mikepurvis/kenwood/audio_pipeline.sch

## KiCad design audio_pipeline.sch (2012-08-21)

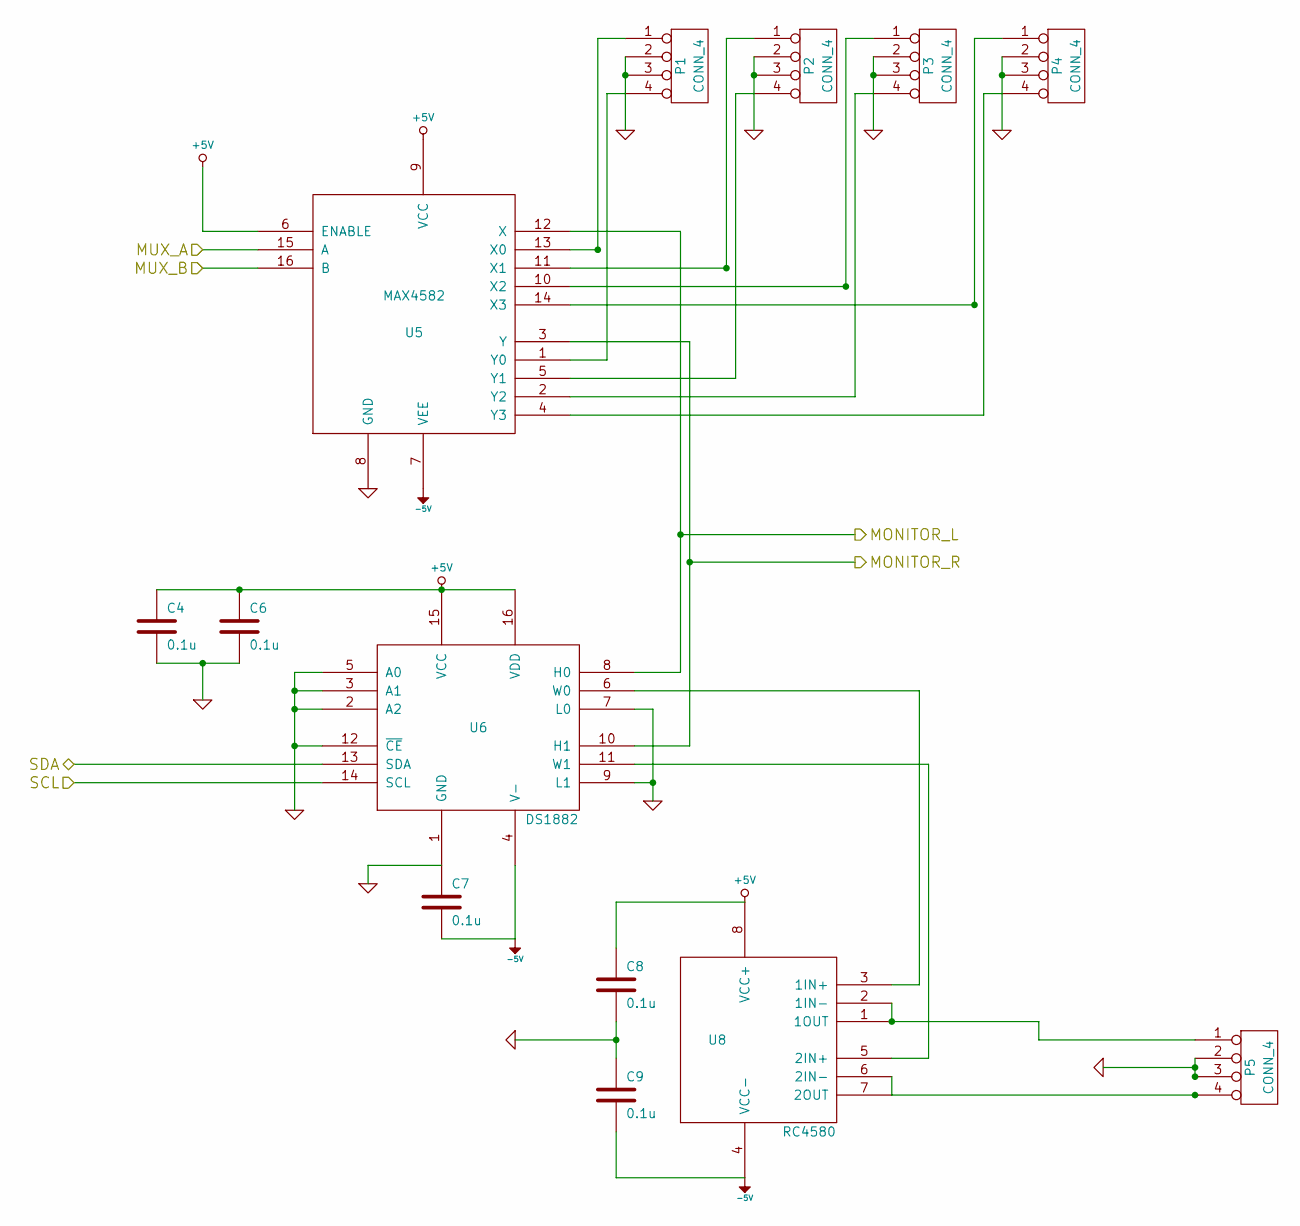
[picture p1: schematic audio_pipeline.sch]

Parts:
C4, C6, C7, C8, C9: 0.1u; Digikey 445-5122-1-ND
P1, P2, P3, P4, P5: CONN_4; Digikey WM4926-ND
U5: MAX4582; MODULE; Digikey MAX4582CSE+-ND
U6: DS1882; SOIC16; Digikey DS1882Z-050+-ND
U8: RC4580; MODULE; Digikey 296-15367-1-ND

Connections:
+5V: C4.1, C6.1, C8.1, U5.6 (ENABLE), U5.9 (VCC), U6.15 (VCC), U6.16 (VDD), U8.8 (VCC+)
-5V: C7.2, C9.2, U5.7 (VEE), U6.4 (V-), U8.4 (VCC-)
GND: C4.2, C6.2, C7.1, C8.2, C9.1, P1.2, P1.3, P2.2, P2.3, P3.2, P3.3, P4.2, P4.3, P5.2, P5.3, U5.8 (GND), U6.1 (GND), U6.2 (A2), U6.3 (A1), U6.5 (A0), U6.7 (L0), U6.9 (L1), U6.12 (~CE)
MONITOR_L: U5.12 (X), U6.8 (H0)
MONITOR_R: U5.3 (Y), U6.10 (H1)
MUX_A: U5.15 (A)
MUX_B: U5.16 (B)
unnamed: P1.1, U5.13 (X0)
unnamed: P1.4, U5.1 (Y0)
unnamed: P2.1, U5.11 (X1)
unnamed: P2.4, U5.5 (Y1)
unnamed: P3.1, U5.10 (X2)
unnamed: P3.4, U5.2 (Y2)
unnamed: P4.1, U5.14 (X3)
unnamed: P4.4, U5.4 (Y3)
unnamed: P5.1, U8.1 (1OUT), U8.2 (1IN-)
unnamed: P5.4, U8.6 (2IN-), U8.7 (2OUT)
unnamed: U6.6 (W0), U8.3 (1IN+)
unnamed: U6.11 (W1), U8.5 (2IN+)
SCL: U6.14 (SCL)
SDA: U6.13 (SDA)
