mikepurvis/kenwood/kenwood.sch

## KiCad design kenwood.sch (2012-08-21, an earlier design)

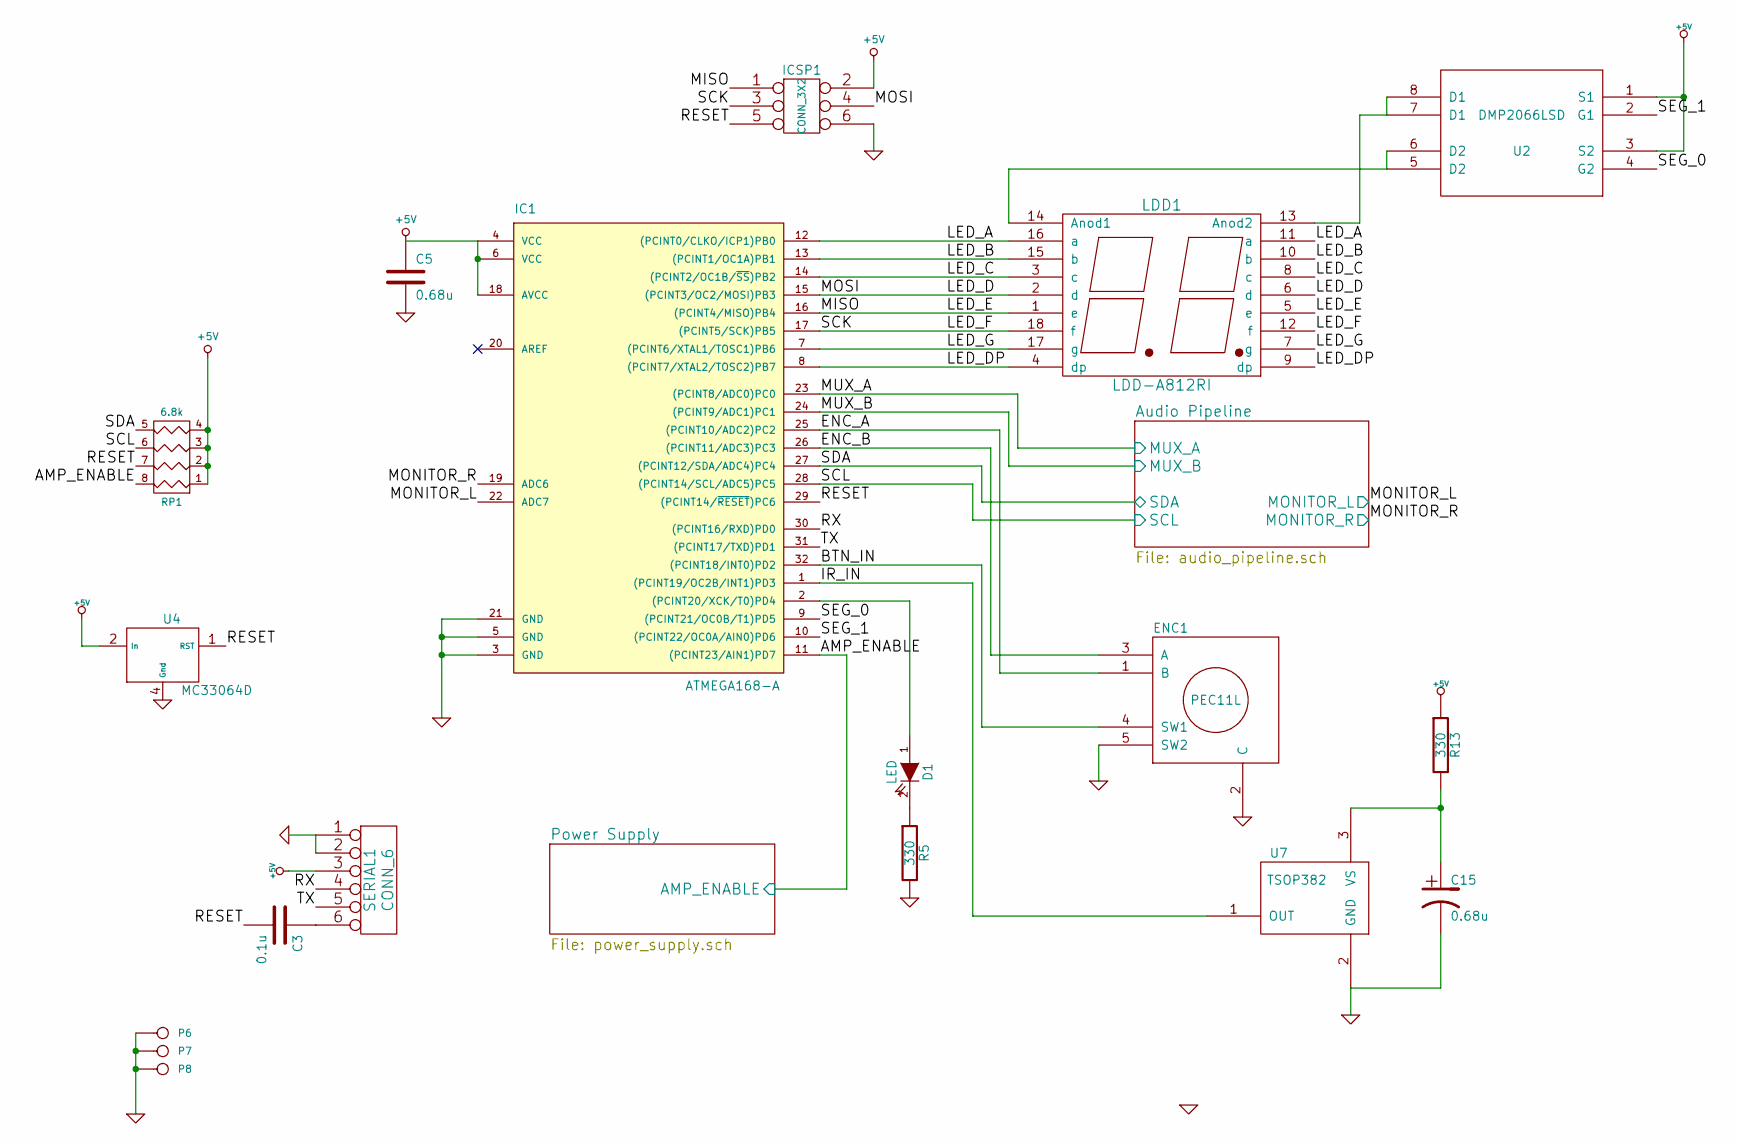
[picture p2: schematic kenwood.sch]

Parts:
C3: 0.1u; Digikey 445-5122-1-ND
C5, C15: 0.68u; Digikey 490-1541-1-ND
D1: LED; Digikey 475-2558-1-ND
ENC1: PEC11L; MODULE; Mouser 652-PEC11-4220K-S24
IC1: ATMEGA168-A; TQFP32; Digikey ATMEGA168A-AU-ND
ICSP1: CONN_3X2; Digikey 609-3218-ND
LDD1: LDD-A812RI; Digikey 67-1470-ND
P6, P7, P8: CONN_1
R5, R13: 330; Digikey P330GCT-ND
RP1: 6.8k; Digikey Y9682TR-ND
SERIAL1: CONN_6; Digikey 609-3263-ND
U2: DMP2066LSD; MODULE; Digikey DMP2066LSDDICT-ND
U4: MC33064D; Digikey MC33064D-5GOS-ND
U7: TSOP382; SIP3; Digikey 751-1227-ND

Connections:
+5V: C5.1, IC1.4 (VCC), IC1.6 (VCC), IC1.18 (AVCC), ICSP1.2, R13.1, RP1.1, RP1.2, RP1.3, RP1.4, SERIAL1.3, U2.1 (S1), U2.3 (S2), U4.2 (In)
AMP_ENABLE: IC1.11 ((PCINT23/AIN1)PD7), RP1.8 (R1)
BTN_IN: ENC1.4 (SW1), IC1.32 ((PCINT18/INT0)PD2)
ENC_A: ENC1.1 (B), IC1.25 ((PCINT10/ADC2)PC2)
ENC_B: ENC1.3 (A), IC1.26 ((PCINT11/ADC3)PC3)
GND: C5.2, C15.2, ENC1.2 (C), ENC1.5 (SW2), IC1.3 (GND), IC1.5 (GND), IC1.21 (GND), ICSP1.6, P6.1, P7.1, P8.1, R5.2, SERIAL1.1, SERIAL1.2, U4.4 (Gnd), U7.2 (GND)
IR_IN: IC1.1 ((PCINT19/OC2B/INT1)PD3), U7.1 (OUT)
LED_A: IC1.12 ((PCINT0/CLKO/ICP1)PB0), LDD1.11 (a), LDD1.16 (a)
LED_B: IC1.13 ((PCINT1/OC1A)PB1), LDD1.10 (b), LDD1.15 (b)
LED_C: IC1.14 ((PCINT2/OC1B/~SS~)PB2), LDD1.3 (c), LDD1.8 (c)
LED_D: IC1.15 ((PCINT3/OC2/MOSI)PB3), ICSP1.4, LDD1.2 (d), LDD1.6 (d)
LED_DP: IC1.8 ((PCINT7/XTAL2/TOSC2)PB7), LDD1.4 (dp), LDD1.9 (dp)
LED_E: IC1.16 ((PCINT4/MISO)PB4), ICSP1.1, LDD1.1 (e), LDD1.5 (e)
LED_F: IC1.17 ((PCINT5/SCK)PB5), ICSP1.3, LDD1.12 (f), LDD1.18 (f)
LED_G: IC1.7 ((PCINT6/XTAL1/TOSC1)PB6), LDD1.7 (g), LDD1.17 (g)
MONITOR_L: IC1.22 (ADC7)
MONITOR_R: IC1.19 (ADC6)
MUX_A: IC1.23 ((PCINT8/ADC0)PC0)
MUX_B: IC1.24 ((PCINT9/ADC1)PC1)
unnamed: C3.1, SERIAL1.6
unnamed: C15.1, R13.2, U7.3 (VS)
unnamed: D1.1 (A), IC1.2 ((PCINT20/XCK/T0)PD4)
unnamed: D1.2 (K), R5.1
unnamed: LDD1.13 (Anod2), U2.7 (D1), U2.8 (D1)
unnamed: LDD1.14 (Anod1), U2.5 (D2), U2.6 (D2)
RESET: C3.2, IC1.29 ((PCINT14/~RESET~)PC6), ICSP1.5, RP1.7 (R2), U4.1 (RST)
RX: IC1.30 ((PCINT16/RXD)PD0), SERIAL1.4
SCL: IC1.28 ((PCINT14/SCL/ADC5)PC5), RP1.6 (R3)
SDA: IC1.27 ((PCINT12/SDA/ADC4)PC4), RP1.5 (R4)
SEG_0: IC1.9 ((PCINT21/OC0B/T1)PD5), U2.4 (G2)
SEG_1: IC1.10 ((PCINT22/OC0A/AIN0)PD6), U2.2 (G1)
TX: IC1.31 ((PCINT17/TXD)PD1), SERIAL1.5
