mikepurvis/kenwood/kenwood_psu.sch

## KiCad design kenwood_psu.sch (2012-08-21)

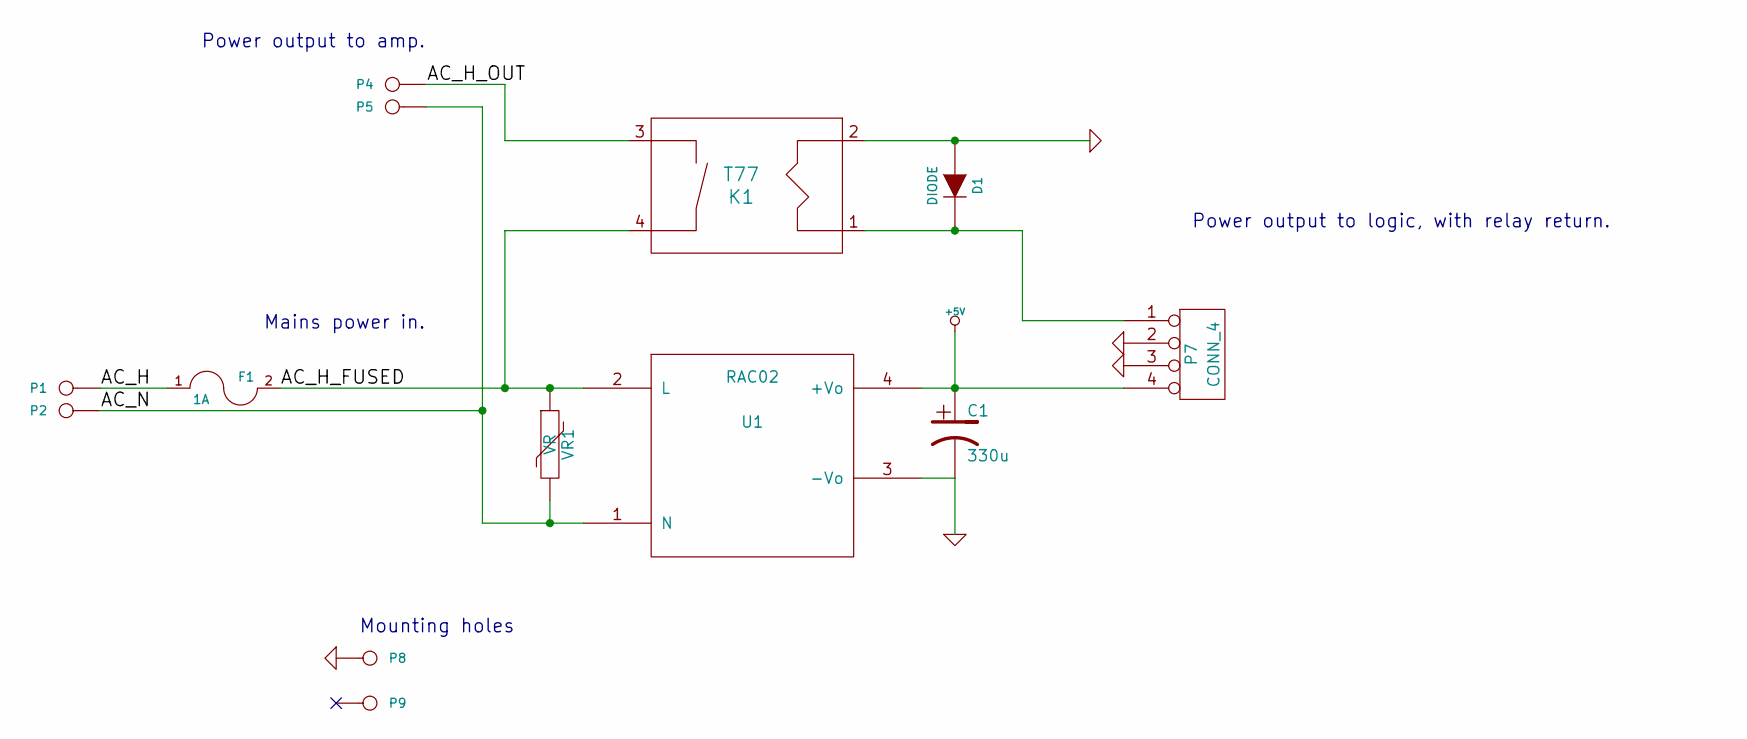
[picture p3: schematic kenwood_psu.sch]

Parts:
C1: 330u; Digikey P5113-ND
D1: DIODE; Digikey 568-4860-6-ND
F1: 1A; Digikey 486-1172-ND,486-1172-ND,F3625-ND
K1: T77
P1, P2, P4, P5, P8, P9: CONN_1
P7: CONN_4; Digikey WM4926-ND
U1: RAC02; MODULE
VR1: VR; Digikey 495-4375-ND

Connections:
+5V: C1.1, P7.4, U1.4 (+Vo)
AC_H: F1.1, P1.1
AC_H_FUSED: F1.2, K1.4, U1.2 (L), VR1.1
AC_H_OUT: K1.3, P4.1
AC_N: P2.1, P5.1, U1.1 (N), VR1.2
GND: C1.2, D1.1 (A), K1.2, P7.2, P7.3, P8.1, U1.3 (-Vo)
unnamed: D1.2 (K), K1.1, P7.1

Notes on the sheet:
Mounting holes
Power output to logic, with relay return.
Mains power in.
Power output to amp.
