mikepurvis/kenwood/power_supply.sch

## KiCad design power_supply.sch (2012-08-21)

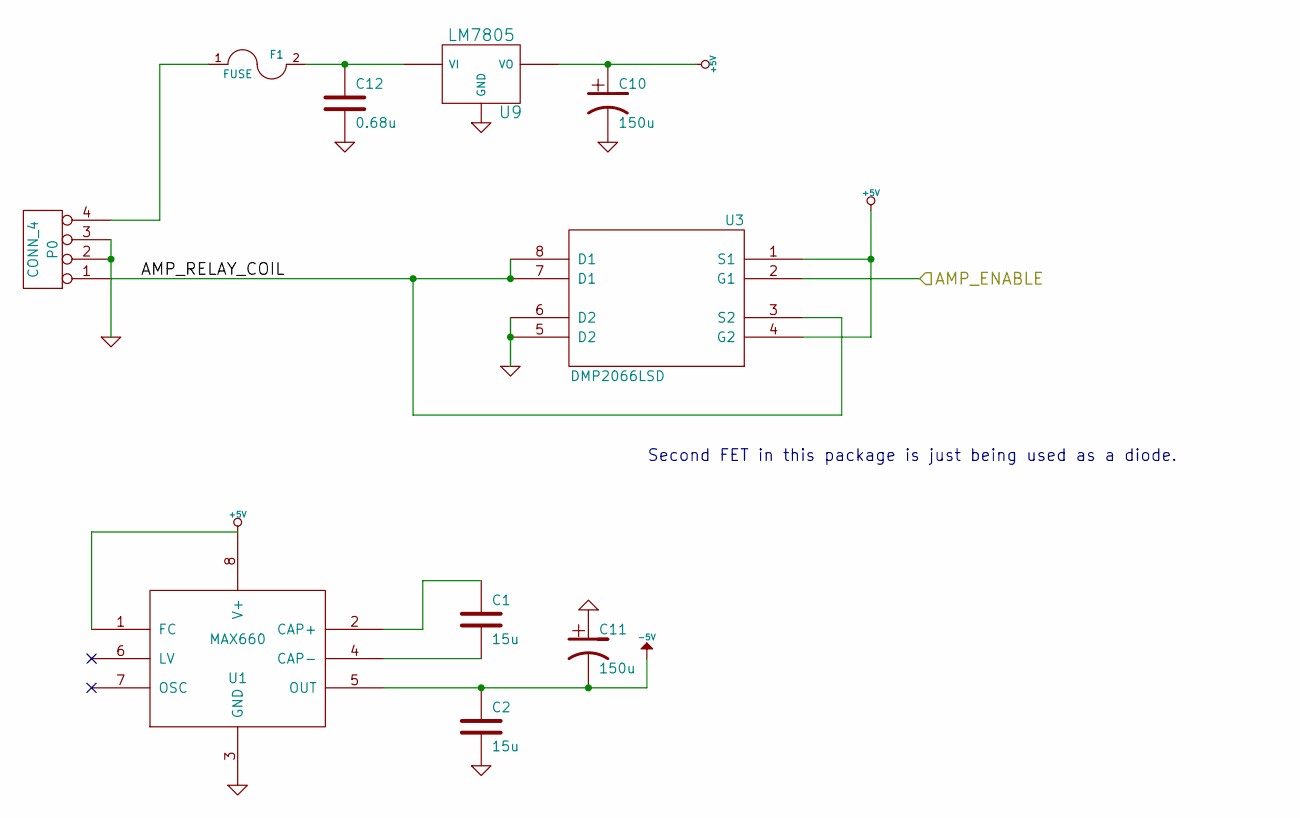
[picture p4: schematic power_supply.sch]

Parts:
C1, C2: 15u; Digikey 445-8027-1-ND
C10, C11: 150u; Digikey P5138-ND
C12: 0.68u; Digikey 490-1541-1-ND
F1: FUSE; Digikey 507-1482-1-ND
P0: CONN_4; Digikey WM4926-ND
U1: MAX660; MODULE; Digikey MAX660M-ND
U3: DMP2066LSD; MODULE; Digikey DMP2066LSDDICT-ND
U9: LM7805; Digikey 497-2957-5-ND

Connections:
+5V: C10.1, U1.1 (FC), U1.8 (V+), U3.1 (S1), U3.4 (G2), U9.VO
-5V: C2.1, C11.2, U1.5 (OUT)
AMP_ENABLE: U3.2 (G1)
AMP_RELAY_COIL: P0.1, U3.3 (S2), U3.7 (D1), U3.8 (D1)
GND: C2.2, C10.2, C11.1, C12.2, P0.2, P0.3, U1.3 (GND), U3.5 (D2), U3.6 (D2), U9.GND
unnamed: C1.1, U1.2 (CAP+)
unnamed: C1.2, U1.4 (CAP-)
unnamed: C12.1, F1.2, U9.VI
unnamed: F1.1, P0.4

Notes on the sheet:
Second FET in this package is just being used as a diode.
