mikepurvis/kenwood/firmware/testbed/uart.c

#include <stdio.h>
#include <avr/io.h>
#include "uart.h"

static FILE mystdout = FDEV_SETUP_STREAM(uart_putchar, NULL, _FDEV_SETUP_WRITE);

void uart_init (void) {
    //1 = output, 0 = input
    DDRB = 0b11101111; //PB4 = MISO 
    DDRC = 0b11111111; //
    DDRD = 0b11111010; //PORTD (RX on PD0)

    UBRR0H = MYUBRR >> 8;
    UBRR0L = MYUBRR;
    UCSR0B = (1<<RXEN0)|(1<<TXEN0);
    
    stdout = &mystdout; //Required for printf init
}

static int uart_putchar(char c, FILE *stream) {
    if (c == '\n') uart_putchar('\r', stream);
  
    loop_until_bit_is_set(UCSR0A, UDRE0);
    UDR0 = c;
    
    return 0;
}

uint8_t uart_getchar(void) {
    while( !(UCSR0A & (1<<RXC0)) );
    return(UDR0);
}
