mikepurvis/kenwood/(commit log)

2012-05-06 Initial commit.
    [audio_pipeline.sch, display.sch, kenwood-164.sch, kenwood-644.sch, kenwood.brd, kenwood.sch, power_supply.sch, serial_connector.sch]
2012-06-03 Switching to atmega164, muxing the two seven-segs instead of using IO exapander.
    [audio_pipeline.sch, display.sch, kenwood.sch, power_supply.sch]
2012-06-15 First experiments with board layout, plus modules for the AC/DC power unit and LCD.
    [audio_pipeline.sch, kenwood.brd, kenwood.sch, power_supply.sch]
2012-06-21 IR recognition with Arduino + breakout
2012-06-22 Remove HDSP lib from kicad project.
2012-06-30 Correcting interrupt off to actually clear the bit.
    [ir.c]
2012-06-30 Blocking off printing in ir.c behind a compile-time guard.
2012-06-30 Splitting off ADC setup stuff to separate file.
2012-06-30 Breaking out UART stuff to separate file as well.
2012-06-30 Compile guard for adc.h
2012-08-01 Removing submodule and extra schematics.
    [kenwood-164.sch, kenwood-644.sch]
2012-08-01 Adding back library files in same repo.
    [audio_pipeline.sch, kenwood.sch, power_supply.sch, serial_connector.sch]
2012-08-01 Changing dual fet module.
    [audio_pipeline.sch, kenwood.brd, kenwood.sch, power_supply.sch]
2012-08-01 Moving back to atmega168, for cost and size reduction, new smaller board layout.
    [audio_pipeline.sch, kenwood.brd, kenwood.sch, power_supply.sch]
2012-08-01 Removing reset circuit, finishing audio circuit.
    [audio_pipeline.sch, kenwood.brd, kenwood.sch, power_supply.sch]
2012-08-02 Final touches on a rev0.0 candidate.
    [audio_pipeline.sch, kenwood.brd, kenwood.sch, power_supply.sch]
2012-08-03 Final board as sent for fab.
    [audio_pipeline.sch, kenwood.brd, kenwood.sch, power_supply.sch]
2012-08-05 Adding part numbers for everything, for BOM preparation.
    [audio_pipeline.sch, kenwood.brd, kenwood.sch, power_supply.sch]
2012-08-21 More updates for BOM purposes.
    [audio_pipeline.sch, kenwood.sch, power_supply.sch]
2012-08-21 5V power supply and relay board for Kenwood amp project.
    [kenwood_psu.brd, kenwood_psu.sch]
2012-09-06 Firmware for display, button, encoder.
